frozen-signal/Apple_IIe_MMU_3V3/(notices)

Notices in the files:
MMU_3V3.kicad_pcb:
Copyright © 2025 by:
Frozen Signal
